stritti/esphome-solar-cisterns-sensor/docs/VERKABELUNG.md

# Deutsche Verdrahtungsreferenz

Die verbindliche deutschsprachige Dokumentation befindet sich unter [de/WIRING.md](de/WIRING.md).
