stritti/esphome-solar-cisterns-sensor/docs/WIRING.md

# Wiring reference

**English** | [Deutsch](de/WIRING.md)

This file is the single authoritative wiring reference for the project. The firmware pin definitions in `wassertank-sensor.yaml` must match this document.

Complete wiring diagram

## Choose one sensor-supply variant

### Variant A: simplest build, without BC327-40

Connect A02YYUW VCC directly to FireBeetle 3V3. Leave GPIO21 unconnected. The sensor works normally, but remains powered during deep sleep and can draw up to 8mA average continuously.

### Variant B: low-power build, with BC327-40

Use connections 1–4 below. This is recommended for battery and solar operation because the sensor is powered only during measurement. The diagram shows this variant.

## Connections

Connections 1–4 apply only to Variant B. All remaining connections apply to both variants.

| No. | From | To | Purpose |
|---:|---|---|---|
| 1 | FireBeetle 3V3 | BC327-40 Emitter | Supply for the switched sensor rail |
| 2 | FireBeetle GPIO21 | 4.7kΩ resistor → BC327-40 Base | Limits the Base current; active-low sensor control |
| 3 | 10kΩ resistor | BC327-40 Base ↔ 3V3 | Pull-up; keeps the sensor off while the GPIO is high-impedance |
| 4 | BC327-40 Collector | A02YYUW VCC | Switched 3.3V sensor supply |
| 5 | FireBeetle GND | A02YYUW GND | Common ground |
| 6 | Switched sensor VCC | A02YYUW RX | Holds RX HIGH while powered for processed output; falls with VCC when switched off |
| 7 | A02YYUW TX | FireBeetle GPIO17 / RX | UART distance data at 9600 baud; receive-only MCU connection |
| 8 | Protected 1-cell Li-ion | FireBeetle PH2.0 | Main battery; verify polarity against the board labels |
| 9 | Nominal 5V solar panel + | FireBeetle VIN | Input to the board’s integrated solar charger |
| 10 | Solar panel GND | FireBeetle GND | Charging and measurement reference |
| 11 | Solar panel + | 33kΩ → divider midpoint | Upper resistor of the solar monitor |
| 12 | Divider midpoint | FireBeetle GPIO1 and 10kΩ → GND | Solar ADC input and lower resistor |

## Energy saving from the optional BC327-40

DFRobot specifies an A02YYUW average current of up to 8mA. With the default 30-minute interval and 7-second on-time, there are 48 cycles and 336 powered seconds per day. The firmware switches `sensor_power` off immediately after the 5-second warm-up and 2-second processing period, before WiFi association, update checks, or an OTA wake window.

| Configuration | Calculation | 3.3V-rail consumption | Energy per day |
|---|---|---:|---:|
| Without power gating | 8mA × 24h | up to 192mAh/day | up to 0.634Wh/day |
| With BC327-40 | (8mA + about 0.55mA Base current) × 336s | about 0.80mAh/day | about 0.0026Wh/day |
| **Saving** | | **about 191mAh/day** | **about 0.631Wh/day (99.6%)** |

The Base-current estimate is `(3.3V - 0.7V) / 4.7kΩ ≈ 0.55mA`. The calculation covers the sensor switching circuit only. Board consumption, WiFi, charging and regulator losses are separate.

The 0.631Wh saving above applies only to the sensor rail. Controller energy depends on total wake time:

| Controller scenario | Awake time per cycle | Approximate energy/day at 3.7V | Ideal 1W-panel time |
|---|---:|---:|---:|
| theoretical lower bound | 7s | 22–24mWh | about 1.5min |
| 60s WiFi + 20s manifest timeouts | 87s | 259–260mWh | about 16min |
| timeouts + 300s OTA every cycle | 387s | about 1.15Wh | about 69min |

Measure actual total wake time and panel yield. Real yield depends on conversion losses, sunlight, angle, shading, season, temperature, and the panel curve.

DFRobot specifies FireBeetle VIN for 5V DC or a 5V solar panel. A “6V” panel can exceed 6V at open circuit. Measure open-circuit voltage in bright sun and use it only if it is within the verified input limit for the exact board revision. The GPIO1 divider can measure 6V safely; this does not prove that VIN can accept it.

## Transistor logic

The BC327-40 is a PNP transistor used as a high-side switch. Its TO-92 package is suitable for breadboards and through-hole prototyping. Verify the Emitter, Base, and Collector pin order against the datasheet for the exact manufacturer before wiring.

| ESPHome switch state | Physical GPIO21 | BC327-40 Base | Sensor |
|---|---:|---|---|
| ON | LOW | Base current through 4.7kΩ | Powered |
| OFF | HIGH | Approximately equal to Emitter voltage | Off |
| Boot or deep sleep, GPIO high-impedance | Held at 3V3 by 10kΩ pull-up | Approximately equal to Emitter voltage | Off |

Do not omit the 4.7kΩ Base resistor: directly connecting the Base to GPIO21 would allow excessive GPIO and Base current. A pull-down on the Base would turn the PNP transistor on during boot and deep sleep and must not be used.

## Solar divider

| Position | Resistor | Connection |
|---|---:|---|
| Upper | 33kΩ | Solar+ to divider midpoint |
| Lower | 10kΩ | Divider midpoint to GND |
| Midpoint | n/a | GPIO1 |

The scale factor is `(33k + 10k) / 10k = 4.3`. A 5.0V panel produces about 1.16V at GPIO1; 6.0V produces about 1.40V. The ESPHome ADC therefore uses `attenuation: 12db` and `multiply: 4.3`.

GPIO1 measures the panel voltage only. Charging uses the separate VIN connection. Never connect Solar+ directly to GPIO1.

## Battery measurement

The FireBeetle 2 ESP32-C6 contains its own battery divider on GPIO0. DFRobot’s example multiplies the GPIO0 voltage by 2. A full 4.2V cell therefore produces about 2.1V at the ADC pin. The ESPHome ADC uses `attenuation: 12db` and `multiply: 2.0`.

Do not add another divider to GPIO0.

## Checks before power-up

1. Disconnect USB, battery, and solar panel.
2. Decide on Variant A or B. Do not combine direct 3V3 sensor power with the switched Collector output.
3. For Variant B, verify that the BC327-40 Emitter connects to 3V3 and Collector connects to sensor VCC.
4. For Variant B, verify 4.7kΩ between GPIO21 and Base, and 10kΩ between Base and 3V3. There must be no Base-to-GND pull-down.
5. For Variant B, verify the BC327-40 pin order against the datasheet for the purchased manufacturer.
6. Verify that A02YYUW RX connects to switched sensor VCC, not GPIO16. This prevents back-powering through RX when the sensor is off.
7. Verify A02YYUW TX connects only to FireBeetle GPIO17 / RX.
8. Verify continuity of all GND connections.
9. Verify that the solar divider is 33kΩ above GPIO1 and 10kΩ below GPIO1.
10. Verify the PH2.0 polarity against the `+` and `-` labels on the FireBeetle board.
11. Power from USB first. For Variant B in debug mode, GPIO21 must be LOW while measuring and HIGH after the sensor is switched off.
12. Confirm with a multimeter that GPIO0 and GPIO1 remain within the ESP32-C6 ADC input range.
13. Before connecting a nominal 6V panel to VIN, measure its open-circuit voltage in bright sun and verify it against the exact board revision's input limit.

## Primary sources

- [DFRobot FireBeetle 2 ESP32-C6 documentation](https://wiki.dfrobot.com/dfr1075/)
- [DFRobot FireBeetle battery-voltage example](https://wiki.dfrobot.com/dfr1075/docs/17359)
- [DFRobot A02YYUW documentation](https://wiki.dfrobot.com/sen0311/)
- [ESPHome ADC sensor documentation](https://esphome.io/components/sensor/adc/)
- [onsemi BC327 / BC327-40 datasheet](https://www.onsemi.com/pdf/datasheet/bc327-d.pdf)
