stritti/esphome-solar-cisterns-sensor/(list of files, drawings)

Other design files:
docs/fritzing/breadboard.fzz
