stritti/esphome-solar-cisterns-sensor/docs/kicad/wassertank.kicad_sch

## KiCad design docs/kicad/wassertank.kicad_sch (2026-08-25, last stored version)

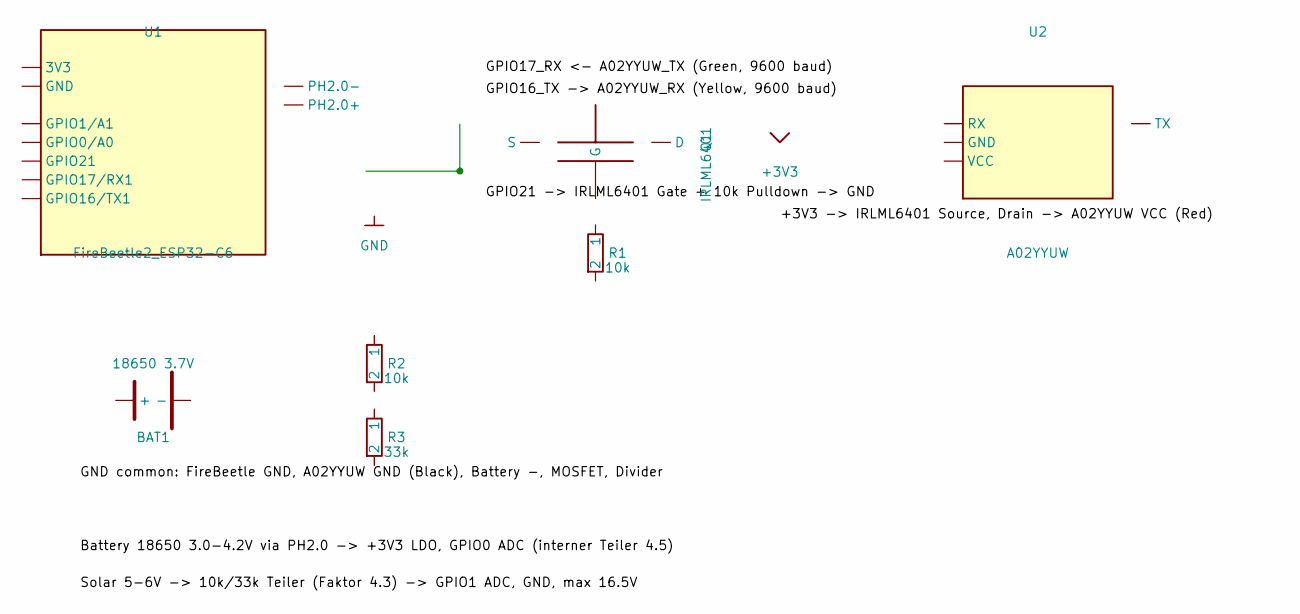
[picture p1: schematic wassertank.kicad_sch]

Parts:
BAT1: 18650 3.7V
Q1: IRLML6401
R1: 10k; R_0805_2012Metric
R2: 10k
R3: 33k
U1: FireBeetle2_ESP32-C6
U2: A02YYUW
