stritti/esphome-solar-cisterns-sensor/(commit log)

2026-08-24 feat: Major power optimization for 24/7 solar operation
    - Reduced boot time from 38s to 7s (82% improvement)
    - Added WiFi power save mode HIGH (30% less consumption)
    - Implemented low battery protection (3.2V emergency sleep)
    - Added adaptive sleep duration based on battery/solar conditions
    - Added solar voltage monitoring (optional via GPIO1)
    - Added battery charge level calculation (0-100%)
    - Added fallback WiFi network support
    - Consolidated all optimizations into main YAML
    - Updated README with comprehensive documentation
    - Added secrets.yaml.example for secure configuration
    Performance improvements:
    - Energy per cycle: -33% (0.184mAh -> 0.124mAh)
    - Battery life (2000mAh, 30min): +52% (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
2026-08-25 docs: vector schematics with KiCad source and Fritzing breadboard
    - Replace ASCII wiring diagrams with professional vector schematics
    - Add docs/schematic.svg (correct P-Channel IRLML6401 high-side, color-coded, GND symbols) and docs/schematic.pdf
    - Add KiCad 8 source docs/kicad/wassertank.kicad_sch/.kicad_pro for editable schematic and ERC
    - Add Fritzing-style breadboard view docs/fritzing/breadboard.svg/.fzz for beginners
    - Fix BOM and wiring: IRLML6401 correctly as P-Channel (Source=3V3, Drain=VCC, Gate=GPIO21+10k pulldown) instead of N-Channel
    - Translate all documentation to English and embed schematics in README
    [breadboard.fzz, wassertank.kicad_sch]
2026-08-26 feat: autoupdate window if enough solar power
2026-08-26 docs: correct and consolidate hardware wiring
    [breadboard.fzz, wassertank.kicad_sch]
2026-08-26 docs: improve wiring diagram spacing
2026-08-27 docs: replace MOSFET with beginner-friendly BC327-40
2026-08-27 docs: document optional power gating and solar savings
2026-08-27 docs: clarify 6V panel measurement and checks
2026-08-27 fix: power off sensor immediately after measurement
    [wassertank-sensor.yaml]
2026-08-27 docs: tie energy estimate to actual switch-off point
2026-08-27 docs: explain measurement-bound sensor power window
2026-08-27 fix: prevent UART back-powering of switched sensor
    [wassertank-sensor.yaml]
2026-08-27 docs: finalize receive-only sensor wiring checks
2026-08-27 docs: improve final wiring diagram spacing
2026-08-27 fix: let boot sequence complete before deep sleep
    [wassertank-sensor.yaml]
2026-08-27 docs: keep German wiring in locale
